mdzio/hm-levelsensor/(commit log)

2019-08-12 pin names of HM modul clarified
2019-11-20 fixed pin numbering
